manolomira/PuroSwing-aTodasVelocidades/Esquema 511_1.png

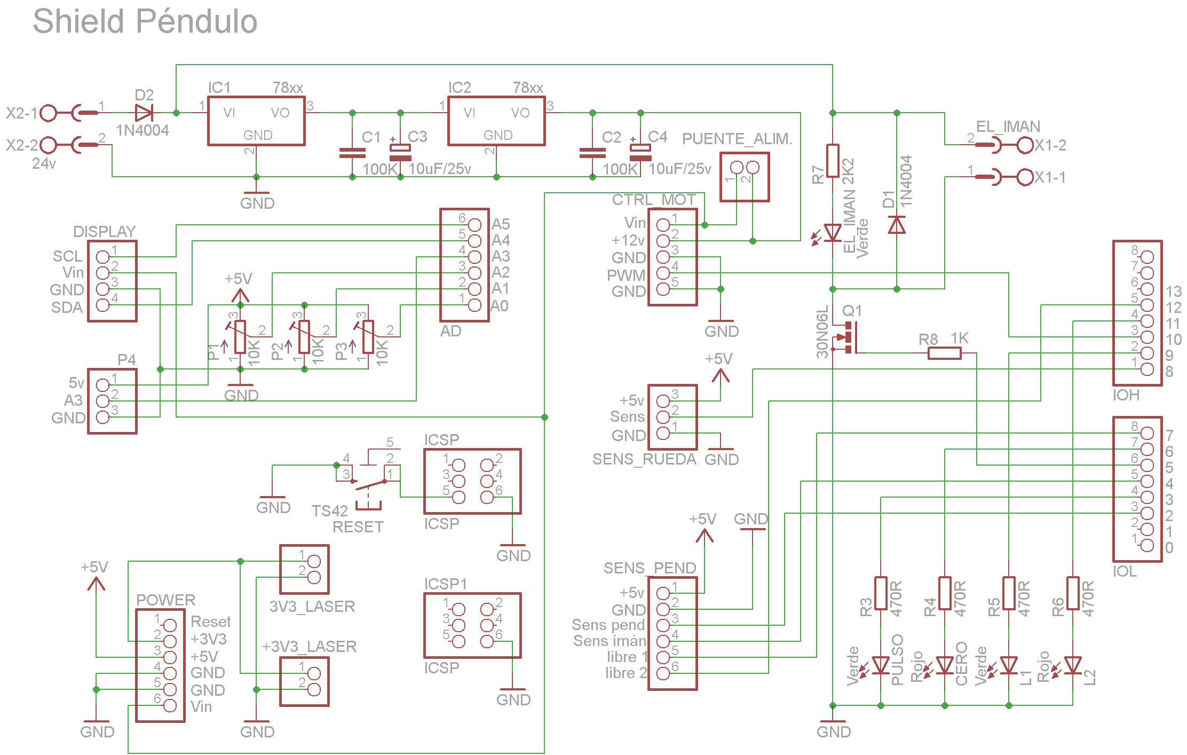
Esquema 511_1.png
