manolomira/PuroSwing-aTodasVelocidades/Tarjeta 511_1.png

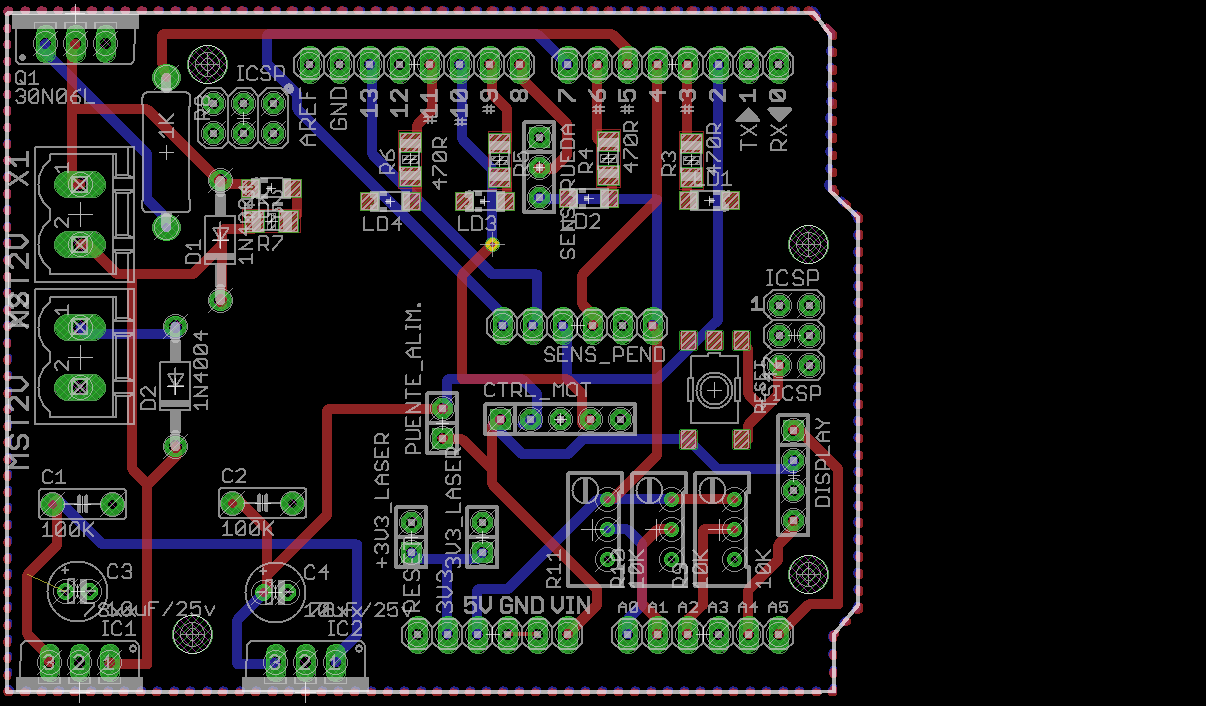
Tarjeta 511_1.png
