manolomira/PuroSwing-aTodasVelocidades/09-23 A TODA VELOCIDAD_A1.pdf

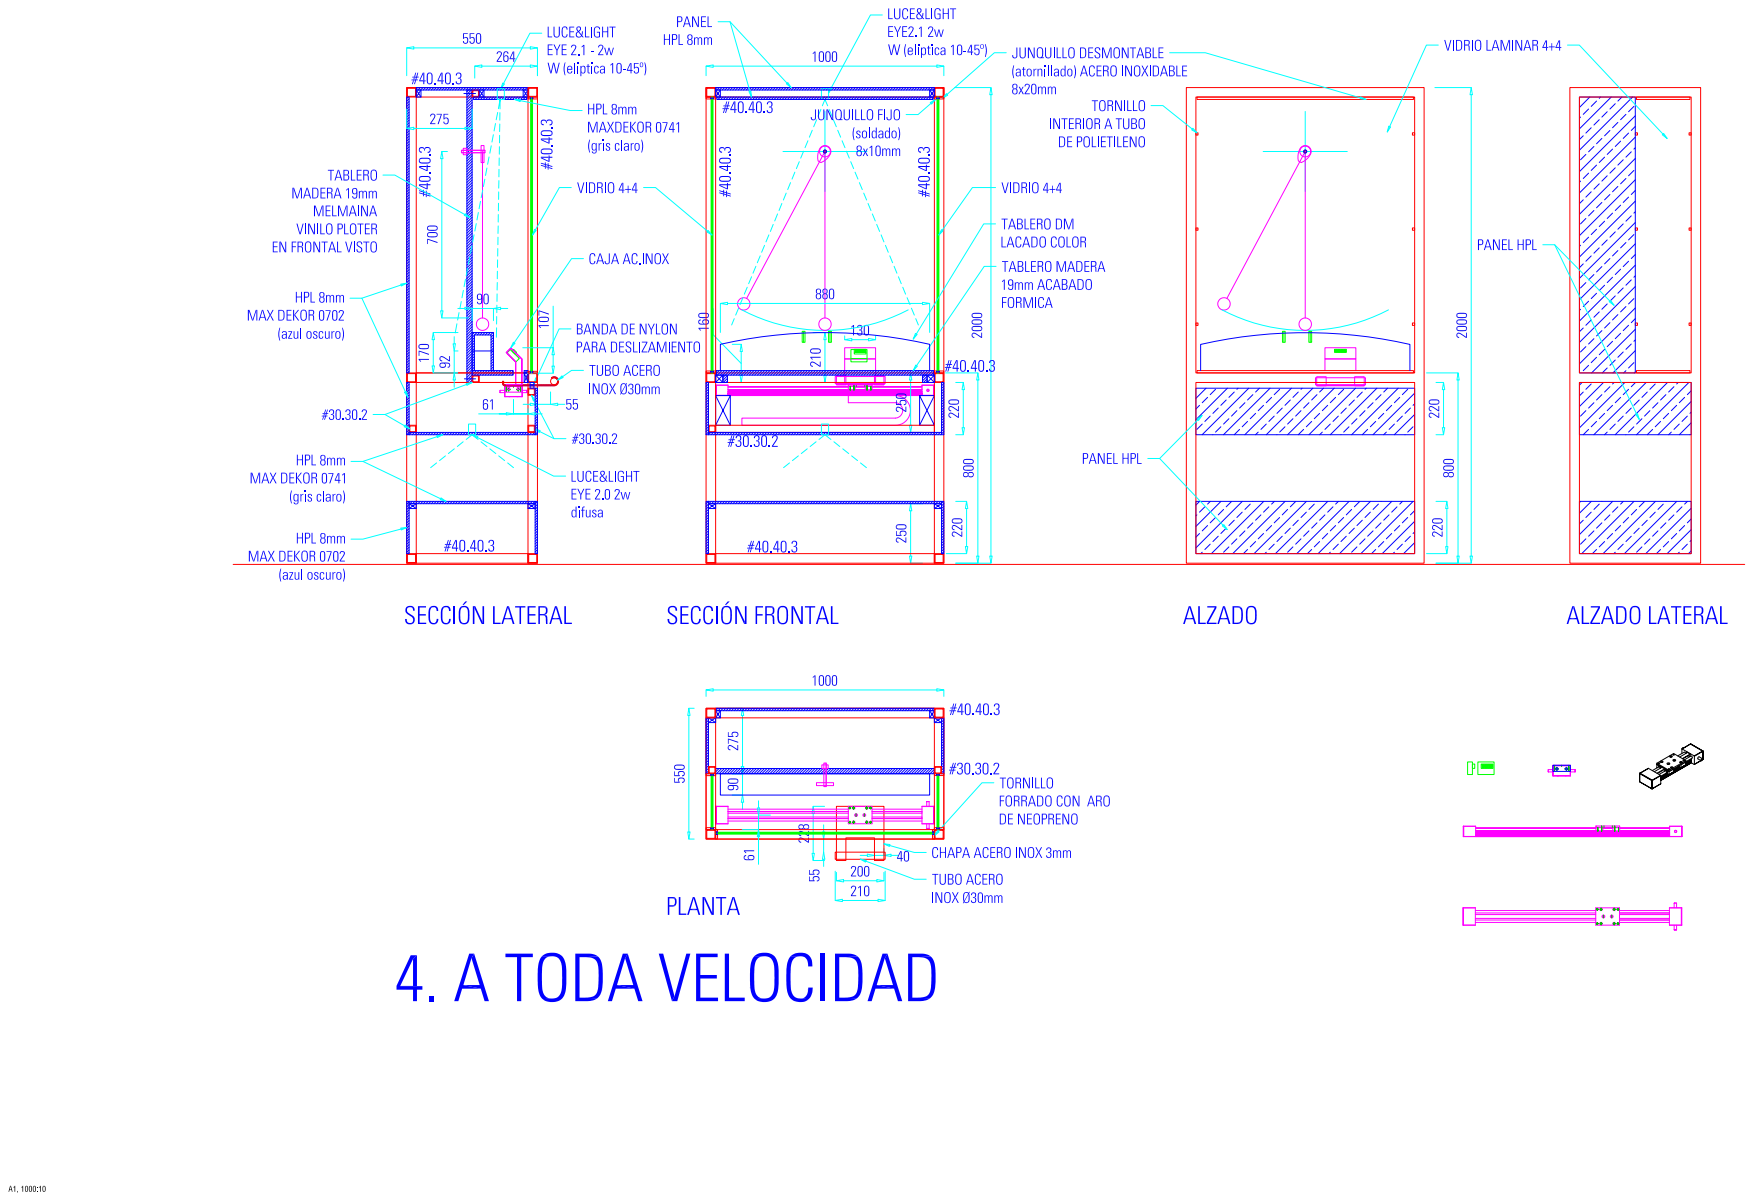
[picture p3: page 1]
