manolomira/PuroSwing-aTodasVelocidades/PenduloPerpetuo/PenduloPerpetuo.ino

/*
SKETCH PARA MODULO PENDULE DE LA EXPOSICION PURO SWING
Adaptado para su uso con Shield Pendulo (version inicial)

Version 26 de septiembre 2014:
.- Añadido el control de amplitud.
.- Corregido el calculo de desfase de la rueda. Se regula con el potenciometro central, unido a A1
.- Extra Ton sigue ajustandose con A0

Disponible en GitHub: https://github.com/manolomira/PuroSwing-Pendule

Basado en sistema de pendulo perpetuo
28-Noviembre-2013

Sensores de barrera optica para el pendulo a trav´s de placa 
    amplificadora
Sensor Hall para la rueda

Salida PWM para controlar un modulo basado en controlador en puente L298
*/


#include <Bounce.h>

// *************** VARIABLES DEL PENDULO ***************

int amplitud, amplitud_max= 38;

// Define entradas y salidas
const int SWInner = 2;       // Entrada de la barrera optica de referencia 
                             // del pendulo
const int LEDInner = 3;      // Indica que se activo la barrera optica de 
                             // referencia del pendulo

const int FinIman = 4;       // Entrada de la barrera optica que indica que 
                             // el pendulo esta cerca del electroiman

const int ElectMag = 5;      // Salida que activa el electriman

// La SALIDA   6 esta reservada para indicar que se activo la barrera FinIman
// La ENTRADA  7 esta reservada como libre1 en el conector SENS_PEND

const int LED_Enclavado = 9; // Salida que indica modo enclavado (L1)

const int LEDElectMag = 11;  // ****** PROVISIONAL *********
                             // Indica que el electroiman esta activado

// la ENTRADA 12 esta reservada como libre2 en el conector SENS_PEND

const int pot1 = A0;         // potenciometro ajuste Extra TON (ANULADO)
const int pot2 = A1;         // potenciometro ajuste Extra desfase
const int pot3 = A2;         // P3 (sin uso)
const int eAnalog = A3;      // Entrada analogica de ajuste
// Las entradas analogicas A4 y A5 se reservan para su uso como bus I2C

const long intervaloSeguridad = 1000;        // tiempo maximo que se activa el electroiman por seguridad

Bounce SWInnerBounce = Bounce( SWInner,50 ); // Referencia del pendulo
Bounce FinImanBounce = Bounce( FinIman,50 ); // Cerca del electroiman

long milliseconds;
long tiempoActual;          // OBSOLETA
long tiempoAnterior;          // OBSOLETA
long tiempoOn;          // OBSOLETA
long tiempoOff;          // OBSOLETA
  
int periodoPendulo;
int intervaloActual;     // OBSOLETA
int intervaloAnterior;    // OBSOLETA
int extraTon;              // OBSOLETA            // tiempo extra calculado a partir del potenciometro

unsigned long T_Pendulo;

// *************** VARIABLES DE LA RUEDA ***************



String texto;



void setup()
{
// *************** VARIABLES DEL PENDULO ***************
  pinMode(SWInner, INPUT);        // optoacoplador de llegada al REED
  pinMode(FinIman,INPUT);         // optoacoplador de llegada al electroiman

  pinMode(LEDInner, OUTPUT);      // indica la activacion del del REED
  pinMode(LEDElectMag, OUTPUT);   // indica la activacion del electroiman
  pinMode(ElectMag, OUTPUT);      // Salida electroiman
  pinMode(LED_Enclavado, OUTPUT); // Salida que indica modo enclavado (L1)
  
  
  Serial.begin(115200);   
}


//  ********** ********** ********** ********** ********** ********** ********** ********** ********** ********** ********** **********  
void loop()
{
   
  // *************** GESTION DEL PENDULO ***************

  
  SWInnerBounce.update ();       // Actualiza las instalacias Bounce del pendulo y detecta flancos de bajada.
  FinImanBounce.update (); 

  ActualizaPendulo();            // Actualiza las variables asociadas al pendulo y enciende sus actuadores

}
  

//  ********** ********** ********** ********** ********** ********** ********** ********** ********** ********** ********** **********  
void ActualizaPendulo()
{
  
  static int zona;
         // zona indica en que zona del recorrido se encuentra el pendulo
         // zona = 0 es la zona opuesta al sensor de control
         // zona = 1 es desde el paso por el centro hasta el sensor de control
         //          calcula los parametros e imprime resultados en esta
         //          zona para evitar retrasar el apagado del pendulo
         // zona = 2 es la zona mas alla del sensor de control
         // zona = 3 es la zona entre el sensor de control y el centro
         //          EN ESTA ZONA SE PRODUCE EL ACTIVAMIENTO DEL ELECTROIMAN
  
  static unsigned long T_0, T_1, T_2, T_3;                   // marca de tiempo de entrada en cada zona
  static unsigned long T_ON, T_Seguridad, T_OFF;             // marca de tiempo para los eventos eventos del pendulo
  int extraT_ON;
 
  static int T_zona_0, T_zona_1, T_zona_2, T_zona_3;         // tiempo en cada zona (milisegundos)
  
  unsigned long milisegundos;                                // Recoge el valor de millis() en cada llamada a la funcion
  milisegundos = millis();
  
  boolean pulsoControl = SWInnerBounce.fallingEdge();      // Detecta flancos de bajada en los detectores opticos.
  boolean pulsoCentro  = FinImanBounce.fallingEdge();


  // *** APAGA EL ELECTROIMAN Y EL LED DE SEÑALIZACION ASOCIADO ***
  if (milisegundos > min (T_Seguridad, T_OFF)) digitalWrite (ElectMag, LOW);                         // Desconecta el electroiman
  if (milisegundos > (T_ON + 15))              digitalWrite (LEDElectMag, LOW);
 
  
  // *** ejecuta las transiciones entre los zonas en funcion de los detectores opticos
  //     en cada cambio de zona registra la marca de tiempo de salida y el tiempo que permanecio en ella
  //     limita el valor registrado de permanencia en cada zona a 10.000 por conpatibilidad con el tipo int 

  switch (zona) {
    case 0:
      if (pulsoCentro)
        {T_1 = milisegundos;  T_zona_0 = min (10000, T_1 - T_0); zona = 1;
        
         // *** HACE LOS CALCULOS EN ESTA ZONA PARA NO RETRASAR EL APAGADO DEL ELECTRIMAN *** 
         // *** CALCULO DE VARIABLES ASOCIADAS AL PENDULO ***

         amplitud = 0.0002 * T_zona_2 * T_zona_2 - 0.1472 * T_zona_2 + 49.125;
         periodoPendulo = T_zona_0 + T_zona_1 + T_zona_2 + T_zona_3;
         T_Pendulo = T_0;            // corresponde al momento del paso por el centro en direccion 
                                     // contraria a la zona del sensor de control


         // *** IMPRESION DE VALORES ASOCIADOS AL PENDULO ***
/*
         Serial.println("--------------------------------");
         Serial.print ("|  PerPend = ");     Serial.print (T_zona_0 + T_zona_1 + T_zona_3);
         Serial.print (" + ");               Serial.print (T_zona_2);
         Serial.print (" = ");               Serial.print (periodoPendulo);

         Serial.print ("\tTpendulo = ");     Serial.print (T_Pendulo);

         Serial.print ("\tT_iman =  ");        Serial.print (T_zona_3);
         Serial.print (" +");               Serial.print (extraT_ON);

         Serial.print ("\t >> amplitud = "); Serial.print (amplitud);
         Serial.print (" (");                Serial.print (amplitud_max);
         Serial.print (")");

         Serial.println ();
*/


         texto = "|  PerPend = " + String(T_zona_0 + T_zona_1 + T_zona_3) + " + " + T_zona_2;
         texto = texto + " = " + periodoPendulo;

         texto = texto + "\tTpendulo = " + T_Pendulo;

         texto = texto + "\tT_iman =  " + T_zona_3 + " +" + extraT_ON;

         texto = texto + "\t >> amplitud = " + amplitud + " (" + amplitud_max + ")";


         Serial.println("--------------------------------");
         Serial.println (texto);
         Serial.println ("--------------------------------");

         Serial.print   ("tiempo de impresion = ");
         Serial.println (millis () - T_1);
      }
      break;
 
    case 1:
      if (pulsoControl)
        {T_2 = milisegundos;  T_zona_1 = min (10000, T_2 - T_1); zona = 2;}
      break;
 
    case 2:
      if (pulsoControl) 
        {T_3 = milisegundos;  T_zona_2 = min (10000, T_3 - T_2); zona = 3;        

        // *** AL ENTRAR EN ZONA 3 SE PRODUCE EL ACTIVAMIENTO DEL ELECTROIMAN  ***
        T_Seguridad = T_3 + 1000;             // establece el maximo tiempo encendido del electroiman
        T_OFF       = T_Seguridad;            // establece provisionalmente el momento de apagado del electroiman

       if (amplitud < amplitud_max)          // solo enciende electroiman si la amplitud es menor de la establecida
        {
          digitalWrite (ElectMag, HIGH);      // Conecta el electroiman y LEDElectroMag como control
          digitalWrite (LEDElectMag, HIGH);
        }
      }
      break;
      
    case 3:
      if (pulsoCentro)
      { T_0 = milisegundos;  T_zona_3 = min (10000, T_0 - T_3); zona = 0;


       // *** AL SALIR DE LA ZONA 3 SE CALCULA EL MOMENTO DE APAGADO DEL ELECTROIMAN ***
       extraT_ON = T_zona_3 / 6;
       extraT_ON = map (analogRead (pot1), 0, 1023, 100, 0);
       T_OFF     = T_0 + extraT_ON;                            // establece el valor correcto para T_OFF

     }
       break;
    default: 
      zona = 0;  // si por algun motivo la variable se sale de margenes vuelve a la zona 0
  }
}
