manolomira/PuroSwing-aTodasVelocidades/(commit log)

2015-07-19 Añadidos ficheros de trabajo
    Incluidas versión de trabajo y versión antigua del sketch
    Idem esquemas y diseño de la placa de control
2015-07-21 Script funcional ATV
    El script funciona con la nueva lógica del péndulo, y con el encoger
    óptico.
    Falta limpiar y ordenar el código.
2015-07-21 Actualizado y limpiado el programa
    Pendiente de prueba en el circuito
2015-07-22 Ajustes Display
    Ajustes en el funcionamiento del display.
    Añadidos nuevos símbolos para el display
    Corregido cálculo de amplitud en caso de fallo de sensor
    Fijado ExtraT_On a 31
    Separado el cálculo del péndulo del cálculo de las transiciones.
2015-07-23 Pendiente de montaje final
    Probado y pendiente del montaje final sobre el módulo
2015-07-28 Añadida documentación
    Añadida docuemtación de los conectores del montaje final en caja.
2015-07-29 Ajustes con modulo montado
    Ajuste de la curva de amplitud
    Implementado indicación de pendulo parado
2015-07-31 ajuste automatico de cer
    Ajusta el valor absoluto del encoger limando los valores extremos. Esto
    permite funcionar en caso de que falle el detector de paso por cero.
